dea82/ExposureBox/README.md

# ExposureBox
AVR based exposure box system
