dea82/ExposureBox/(threads)

Thread 2 (2015-05-25):

First ADC conversion may be wrong when using internal bandgap

dea82, 2015-05-25:
First ADC conversion may be wrong when using internal bandgap as reference voltage. Make sure that a false power down is not triggered!

dea82, 2015-08-21:
Should not be a problem as this Analogue Comparator is used.

Closed 2015-08-21.

Thread 3 (2015-05-29):

Check WDT-reset

dea82, 2015-05-29:
According to AVR132 chap. 2.4 the WDT flag shall be evaluated during startup. Maybe the WDT shall be run all the time and acually trigger a system reset instead?

"When designing for devices having the Enhanced Watchdog Timer, it is important to
evaluate the WDT Reset Flag in the startup code. This applies even if the application
never intends to use the WDT. If the WDT System Reset Mode should unintentionally
be enabled and cause a system reset, the WDT Reset Flag will be set and the WDT
System Reset Mode is kept enabled after the system reset. Therefore the startup
code should check the WDT Reset Flag and disable the WDT System Reset Mode if
it is enabled but never used. These considerations apply when the WDTON fuse is
unprogrammed only. If the WDTON fuse is programmed, the WDT System Reset
Mode is always enabled. How to change the fuse settings is described in the device
datasheets. "

Closed 2015-08-21.
