dea82/ExposureBox/pcb/UV_box_v2.2.sch

## EAGLE design pcb/UV_box_v2.2.sch (2015-07-22)

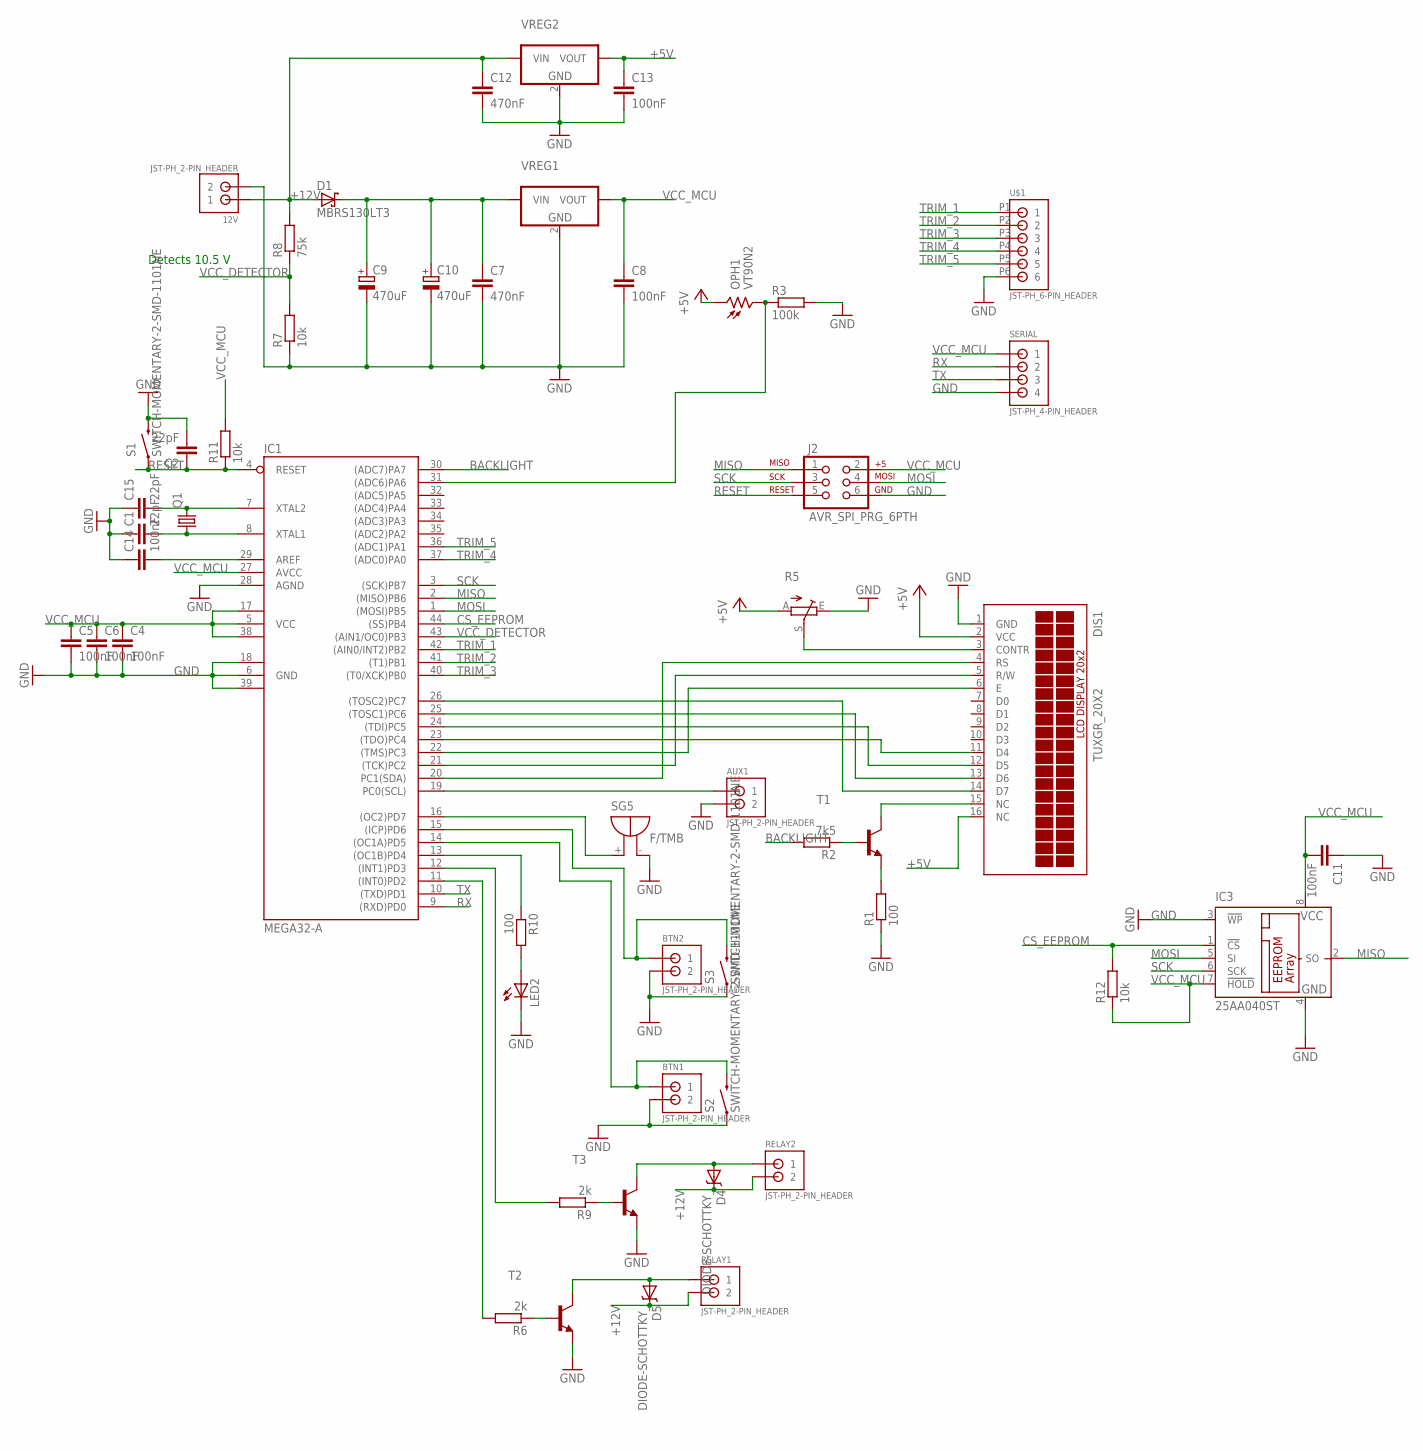
[picture p1: schematic UV_box_v2.2.sch]

Parts:
12V: JST-PH_2-PIN_HEADER; JST_B2B-PH_HEADER
AUX1: JST-PH_2-PIN_HEADER; JST_B2B-PH_HEADER
BTN1, BTN2: JST-PH_2-PIN_HEADER; JST_B2B-PH_HEADER
C1, C2, C15: 22pF; C0805
C4, C5, C6, C8, C11, C13, C14: 100nF; C0805
C7, C12: 470nF; C0805
C9, C10: 470uF; 140CLH-0810
D1: MBRS130LT3; SMB
D4, D5: DIODE-SCHOTTKY_; SMA-DIODE
DIS1: TUXGR_20X2
IC1: MEGA32-A; TQFP44
IC3: 25AA040ST; TSSOP8
J2: AVR_SPI_PRG_6PTH; 2X3
LED2: LEDCHIPLED_0805; CHIPLED_0805
OPH1: VT90N2; VT900
Q1: CRYSTALHC49S; HC49/S
R1: 100; R1206
R2: 7k5; R1206
R3: 100k; R1206
R5: TRIM_EU-B25P; B25P
R6, R9: 2k; R1206
R7, R11, R12: 10k; R1206
R8: 75k; R1206
R10: 100; R0805
RELAY1, RELAY2: JST-PH_2-PIN_HEADER; JST_B2B-PH_HEADER
S1, S2, S3: SWITCH-MOMENTARY-2-SMD-1101NE; TACTILE-SWITCH-1101NE
SERIAL: JST-PH_4-PIN_HEADER; JST_B4B-PH_HEADER
SG5: F/TMB
T1, T2, T3: BC847B-NPN-SOT23-BEC; SOT23-BEC
U$1: JST-PH_6-PIN_HEADER; JST_B6B-PH_HEADER
VREG1, VREG2: VREG_3PINS-D2PAK; D2PAK

Connections:
+5V: C13.1, DIS1.2 (VCC), DIS1.16 (NC), OPH1.1, R5.A, VREG2.3 (VOUT)
+12V: 12V.P1 (1), C12.1, D1.A, D4.C, D5.C, R8.2, RELAY1.P2 (2), RELAY2.P2 (2), VREG2.1 (VIN)
BACKLIGHT: IC1.30 ((ADC7)PA7), R2.2
CS_EEPROM: IC1.44 ((SS)PB4), IC3.1 (!CS), R12.2
GND: 12V.P2 (2), AUX1.P2 (2), BTN1.P2 (2), BTN2.P2 (2), C1.1, C2.2, C4.2, C5.2, C6.2, C7.2, C8.2, C9.-, C10.-, C11.1, C12.2, C13.2, C14.1, C15.1, DIS1.1 (GND), IC1.6 (GND), IC1.18 (GND1), IC1.28 (AGND), IC1.39 (GND2), IC3.3 (!WP), IC3.4 (GND), J2.6, LED2.C, R1.1, R3.2, R5.E, R7.1, S1.P$2 (2), S2.P$1 (1), S3.P$1 (1), SERIAL.P4 (4), SG5.-, T2.E, T3.E, U$1.P6 (6), VREG1.2 (GND), VREG2.2 (GND)
MISO: IC1.2 ((MISO)PB6), IC3.2 (SO), J2.1
MOSI: IC1.1 ((MOSI)PB5), IC3.5 (SI), J2.4
unnamed: R1.2, T1.E
unnamed: DIS1.15 (NC), T1.C
unnamed: DIS1.3 (CONTR), R5.S
unnamed: R2.1, T1.B
unnamed: DIS1.4 (RS), IC1.20 (PC1(SDA))
unnamed: DIS1.5 (R/W), IC1.21 ((TCK)PC2)
unnamed: DIS1.6 (E), IC1.22 ((TMS)PC3)
unnamed: C15.2, IC1.7 (XTAL2), Q1.2
unnamed: C1.2, IC1.8 (XTAL1), Q1.1
unnamed: IC1.16 ((OC2)PD7), SG5.+
unnamed: DIS1.11 (D4), IC1.23 ((TDO)PC4)
unnamed: DIS1.12 (D5), IC1.24 ((TDI)PC5)
unnamed: C7.1, C9.+, C10.+, D1.C, VREG1.1 (VIN)
unnamed: DIS1.13 (D6), IC1.25 ((TOSC1)PC6)
unnamed: DIS1.14 (D7), IC1.26 ((TOSC2)PC7)
unnamed: C14.2, IC1.29 (AREF)
unnamed: IC1.31 ((ADC6)PA6), OPH1.2, R3.1
unnamed: AUX1.P1 (1), IC1.19 (PC0(SCL))
unnamed: BTN2.P1 (1), IC1.15 ((ICP)PD6), S3.P$2 (2)
unnamed: BTN1.P1 (1), IC1.14 ((OC1A)PD5), S2.P$2 (2)
unnamed: IC1.11 ((INT0)PD2), R6.2
unnamed: R6.1, T2.B
unnamed: D5.A, RELAY1.P1 (1), T2.C
unnamed: IC1.12 ((INT1)PD3), R9.2
unnamed: R9.1, T3.B
unnamed: D4.A, RELAY2.P1 (1), T3.C
unnamed: IC1.13 ((OC1B)PD4), R10.1
unnamed: LED2.A, R10.2
RESET: C2.1, IC1.4 (RESET), J2.5, R11.1, S1.P$1 (1)
RX: IC1.9 ((RXD)PD0), SERIAL.P2 (2)
SCK: IC1.3 ((SCK)PB7), IC3.6 (SCK), J2.3
TRIM_1: IC1.42 ((AIN0/INT2)PB2), U$1.P1 (1)
TRIM_2: IC1.41 ((T1)PB1), U$1.P2 (2)
TRIM_3: IC1.40 ((T0/XCK)PB0), U$1.P3 (3)
TRIM_4: IC1.37 ((ADC0)PA0), U$1.P4 (4)
TRIM_5: IC1.36 ((ADC1)PA1), U$1.P5 (5)
TX: IC1.10 ((TXD)PD1), SERIAL.P3 (3)
VCC_DETECTOR: IC1.43 ((AIN1/OC0)PB3), R7.2, R8.1
VCC_MCU: C4.1, C5.1, C6.1, C8.1, C11.2, IC1.5 (VCC), IC1.17 (VCC1), IC1.27 (AVCC), IC1.38 (VCC2), IC3.7 (!HOLD), IC3.8 (VCC), J2.2, R11.2, R12.1, SERIAL.P1 (1), VREG1.3 (VOUT)

Notes on the sheet:
Detects 10.5 V
