dea82/ExposureBox/src/buzz.c

/******************************************************************************
 * Copyright (C) 2014 Andreas, Sweden
 * <andreas.laghamn@gmail.com>
 * http://laghamn.dyndns.org
 *****************************************************************************
 *
 * File    : buzz.c
 * Date    : 28 maj 2014
 * 
 * Summary : TODO
 *
 *****************************************************************************/

/******************************************************************************
 * Includes
 *****************************************************************************/

#include "gpio.h"
#include "types.h"

/******************************************************************************
 * Function prototypes
 *****************************************************************************/

/******************************************************************************
 * Functions
 *****************************************************************************/

void Buzz_init(void)
{
    gpio_conf(BUZZ_CFG, OUTPUT, 0);
}

void Buzz_10ms(void)
{
    static tU16 time = 0;
    time++;
    if(time > 20)
    {
        //gpio_set(BUZZ_CFG);
        time = 0;
    }
    else if (time > 1) {
        gpio_clr(BUZZ_CFG);
    }
}
