dea82/ExposureBox/(commit log)

2015-03-26 First update.
    [assy.obj]
2015-04-08 Update before removing enumerated type and replace it with number of bytes.
    [dast.c, dast.h, eepr.c, eepr.h, types.h]
2015-04-25 - Updates of data storage. - Removed unused files.
    [assy.obj]
2015-07-22 Added pcbs.
    [UV_box_v2.2.brd, UV_box_v2.2.sch]
2015-08-21 This closes #4: Bug in butt.c
    Task-Url: http://github.com/dea82/ExposureBox/issues/issue/4
    [butt.c]
2015-08-21 Fixes #5: Replace Util_safeInc... with macro from AVR-HVSP which is much more space optimized
    Task-Url: http://github.com/dea82/ExposureBox/issues/issue/5
    [butt.c, types.h, util.c, util.h]
2015-08-21 Fixes #2: First ADC conversion may be wrong when using internal bandgap
    Task-Url: http://github.com/dea82/ExposureBox/issues/issue/2
    [pomm.c]
2015-08-21 Fixes #3: Check WDT-reset
    Task-Url: http://github.com/dea82/ExposureBox/issues/issue/3
    [main.c]
2015-08-21 Fixes #6: Implement data storage copy function
    Task-Url: http://github.com/dea82/ExposureBox/issues/issue/6
    [dast.c, dast.h]
